rogerio-silva/autonomous-car/(list of files, drawings)

Other design files:
docs/assembly/autonomous-car.fz
docs/assembly/autonomous-car.fzz
