rogerio-silva/autonomous-car/(commit log)

2026-06-27 infra: estrutura inicial, documentacao e workflow do projeto (#1) (#2)
    Fundacao do carro autonomo (Arduino Mega 2560 + HuskyLens):
    - Estrutura PlatformIO (include/, src/, lib/) e platformio.ini
    - Esqueleto de firmware modular: motors (2WD/L298N), sensors
    (HC-SR04 + IR), vision (HuskyLens I2C) e maquina de estados em main
    - README.md e CLAUDE.md (diretrizes de desenvolvimento)
    - docs/: requirements, architecture, hardware (BOM+pinout),
    vision-huskylens, git-workflow e roadmap (M1-M5)
    - .gitignore
    Closes #1
2026-06-27 feat: locomocao 2WD controlada por serial com rampas e trim (#5) (#6)
    M2 - Plataforma & Locomocao (modo manual, nao-bloqueante):
    - motors: rampas de aceleracao nao-bloqueantes, controle diferencial,
    trim por motor e failsafe por timeout de comando
    - storage: persistencia da calibracao (trim) na EEPROM (magic+versao)
    - commands: CLI serial estilo WASD (mover, velocidade, trim, salvar,
    status, telemetria, ajuda)
    - main: loop nao-bloqueante sem delay()
    - config: constantes de rampa, failsafe, trim e EEPROM
    - docs: serial-control.md, diagrama L298N + energia em hardware.md,
    atualizacao de architecture, requirements e roadmap
    Tambem atualiza o processo: branches sao preservadas apos o merg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
    [commands.cpp, commands.h, config.h, main.cpp, motors.cpp, motors.h, storage.cpp, storage.h]
2026-06-27 docs: montagem completa do carro (esquematico SVG + matriz + Fritzing) (#7) (#8)
    Completa o item de Fritzing pendente do M2, cobrindo TODOS os componentes:
    - docs/assembly/schematic.svg: diagrama de ligacao (renderiza no GitHub)
    - docs/assembly/README.md: matriz de conexoes completa + layout ASCII +
    checklist de montagem
    - docs/assembly/fritzing-guide.md: lista de pecas, netlist e passo-a-passo
    para gerar o .fzz nativo no app Fritzing
    - docs/assembly/autonomous-car.fz/.fzz: arquivo Fritzing best-effort, com
    aviso explicito de que pode abrir incompleto (gerado sem o app/pecas)
    - hardware.md e README.md: apontam para a montagem completa
    Closes #7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
    [autonomous-car.fz, autonomous-car.fzz]
2026-06-27 feat: sensoriamento - desvio de obstaculo e seguir-linha (M3) (#9) (#10)
    M3 - Sensoriamento (modos autonomos nao-bloqueantes):
    - behaviors: modos MANUAL / SEGUIR-LINHA / DESVIO
    - seguir-linha por erro ponderado (controle proporcional) + busca
    - desvio: manobra parar->recuar->girar->retomar, alternando o lado
    - sensors: HC-SR04 filtrado por mediana (telemetria) e ping unico
    (controle); IR de linha com limiares e polaridade calibraveis
    - storage: cache central de config (fonte unica) + persistencia dos
    limiares IR junto com o trim; versao da EEPROM incrementada p/ 2
    - commands: teclas de modo (m/l/v) e calibracao IR (c/f/g); em AUTO,
    espaco/x e parada de emergencia (volta a MANUAL);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
2026-06-27 feat: visao - rastreio de alvo HuskyLens (Tag) com aproximacao (M4) (#11) (#12)
    M4 - Visao Computacional (novo modo autonomo RASTREIO):
    - behaviors: modo TRACK_TARGET
    - esterco proporcional ao erro horizontal da HuskyLens
    - aproxima e para a uma distancia-alvo (altura do bloco) com trava
    de seguranca por ultrassom
    - alvo perdido: gira procurando (janela) e depois para
    - vision: centro do quadro alinhado a VISION_FRAME_W; leitura do maior
    bloco (valido para Tags), com ID/posicao/erro horizontal
    - commands: tecla p=RASTREIO e i=info de visao (alvo/ID/erro)
    - main: vision::begin() no setup + dispatch por modo
    - config: constantes VISION_* (ganho, aproximacao, limiar de tamanho, busc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
2026-06-27 feat: autonomia - navegacao por fusao sensores+visao (M5) (#13) (#14)
    M5 - Autonomia (encerra o roadmap):
    - behaviors: modo NAVIGATE (arbitrador subsumption por prioridade)
    Seguranca (desvio) > Alvo visual (Tag) > Seguir-linha > Ocioso (busca)
    - manobra de desvio latcheada (conclui antes de re-arbitrar)
    - refator: nucleos reutilizaveis (steerByLine, steerByVision, desvio)
    compartilhados pelos modos isolados e pelo NAVIGATE
    - commands: tecla N=NAVEGACAO; status mostra a camada ativa
    (modo=NAVEGACAO(CAMADA)); ajuda atualizada
    - main: boot sempre em MANUAL (seguro)
    - config: NAV_SEARCH_SPEED (giro de busca no ocioso)
    - docs: requirements M5, maquina de estados final (architecture),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
2026-06-27 docs: guia de teste de bancada (montagem -> motores -> sensores -> autonomia) (#15) (#16)
    Adiciona docs/bench-test.md: checklist incremental e seguro para validar
    o carro fisicamente, etapa por etapa (boot, motores, sensores,
    comportamentos, visao e navegacao), com permissao de porta (dialout),
    gravacao/monitoramento, tabela de registro e troubleshooting.
    Linka o guia no README.
    Closes #15
2026-06-27 docs: detalha secao de energia (pack 2S 18650, buck 5V, seguranca) (#17) (#18)
    Expande hardware.md secao 3 (Energia):
    - numero de celulas: 2S (7.4V) minimo/recomendado; 2S2P para autonomia,
    com tabela de tensoes (nominal/cheia/vazia)
    - como ligar em serie + chave + GND comum (diagrama ASCII)
    - alimentacao da logica: VIN simples vs buck 5V (recomendado)
    - jumper 5V do L298N; seguranca Li-ion (holder/BMS 2S, carga
    balanceada, fusivel, polaridade)
    - aviso: 9800mAh em 18650 e spec falsa (real ~2500-3500mAh)
    - BOM atualizada (celulas, holder 2S, BMS, buck, fusivel)
    Closes #17
2026-06-27 feat: expoe IR de obstaculo e flag obstacleAhead na telemetria (#19) (#20)
    - printStatus passa a mostrar irObst (sensors::irObstacle) e obst
    (sensors::obstacleAhead), para validacao/diagnostico na bancada
    - corrige cabecalho da ajuda de "(M3)" para "(M5)"
    Validado no hardware: campos aparecem no status; cabecalho M5.
    Closes #19
    [commands.cpp]
2026-06-27 docs: bitola dos cabos do pack + secao de carregamento (futuro) (#21) (#22)
    hardware.md:
    - 3.6 Bitola dos cabos: tabela por trecho (potencia AWG20, buck/logica
    AWG22-24, balanceamento AWG24-26, sinais AWG24-28) + notas (silicone,
    cabos curtos, fusivel ~3-5A)
    - 5. Carregamento da bateria (DESENVOLVIMENTO FUTURO): diretrizes CC/CV
    ate 8.4V, balanceamento obrigatorio, opcoes A/B/C e papel do BMS
    (protecao, nao carregador); detalhamento a definir
    Closes #21
2026-06-28 docs: adiciona prompt de IA para projeto de chassi + bolha (#23) (#24)
    - novo docs/assembly/prompt-chassi-bolha.md (prompt PT-BR detalhado,
    com restricoes do projeto, posicionamento sensorial e OpenSCAD)
    - link a partir de docs/assembly/README.md (secao Projeto mecanico)
    - requisito registrado em docs/requirements.md
    Claude-Session: https://claude.ai/code/session_01WGnxVgKuPT9nvRPGrPPde9
2026-06-28 docs: preenche medidas reais (powerbank, motor, rodas) no prompt de chassi (#25)
    - powerbank 85x45x45; motor DC 70x32x22; roda+pneu O66 (raio 33) x 25
    - resta confirmar apenas o arranjo da roda dianteira
    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
2026-06-28 docs: powerbank sobre eixo traseiro + caixa de encaixe dos eletronicos no prompt (#26)
    - powerbank centralizado e proximo ao eixo de tracao (massa sobre as motrizes)
    - requisito de capa/caixa com desniveis (recessos) para encaixe dos modulos,
    com travas anti-vibracao e possiveis niveis/andares
    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
2026-06-28 docs: define 2 rodas dianteiras livres no prompt de chassi (#27)
    - rodas dianteiras (2x) livres, mesmas O66 x 25 das motrizes
    - todas as medidas preenchidas: prompt pronto para uso
    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
2026-06-28 hardware: projeto CAD do chassi+bolha (OpenSCAD) + correção de inconsistências (#43)
    * hardware: adiciona projeto CAD chassi+bolha (OpenSCAD, gerado por IA) (#42)
    Importa o modelo parametrico (chassi, tray, suportes, bolha sedan) e a
    documentacao, gerados a partir de docs/assembly/prompt-chassi-bolha.md.
    Estado original da IA; correcoes vem no commit seguinte.
    * fix: corrige inconsistencias do CAD chassi+bolha e integra docs (#42)
    Correcoes (validadas renderizando tray/assembly no OpenSCAD):
    - powerbank com dimensoes reais 85x45x45 (era 92x52x46)
    - elimina co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
    [chassi-bolha.scad]
2026-08-20 docs: corrige status de M4/M5 no roadmap (#44) (#45)
    M4 e M5 já têm todas as issues fechadas no GitHub, mas o roadmap.md
    ainda marcava M4 inconsistente (🚧 no cabeçalho vs ✅ na tabela) e
    M5 como 🚧 em ambos os lugares.
